DavidMS51/TFWordclock/8x8r8a.pdf

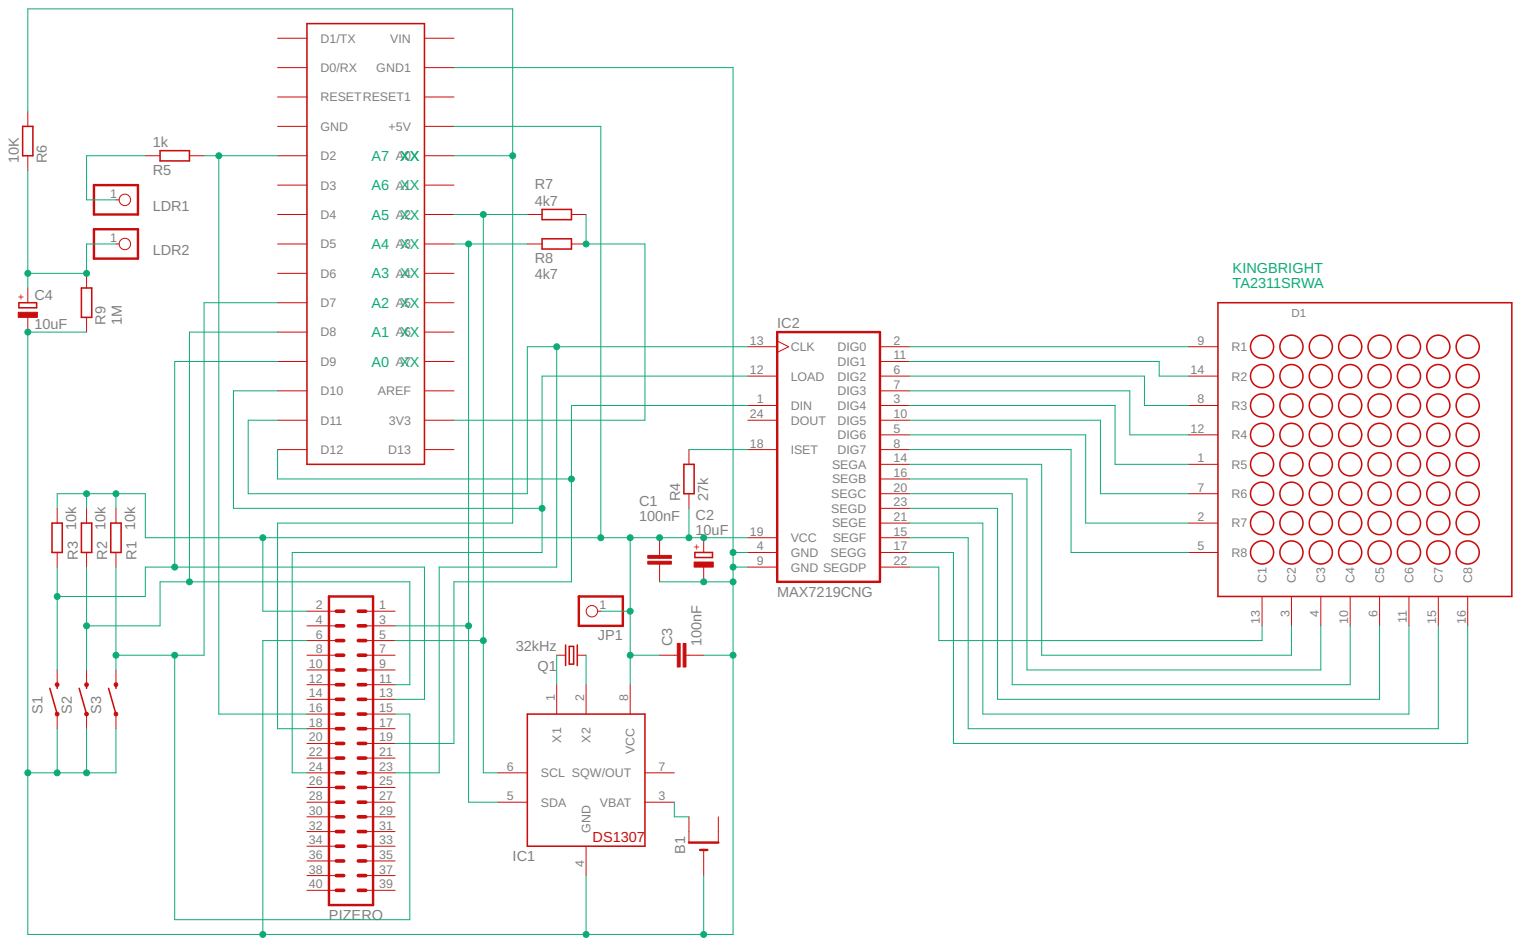
[picture p50: page 1]
