DavidMS51/TFWordclock/(commit log)

2016-05-18 Beta Arduino software added
2016-05-27 fixed spelling on a few strings
    [FT_WordClock_R1_English.ino]
2016-06-19 Update to Python code to include rotation feature
    Rotation option added to Python code
    manual updated to reflect this and some other minor corrections /
    improvements made
    [Wordclockr1.py, Wordclockr2.py, timewrd2ca.py, timewrd3ca.py]
2016-07-24 s/w update to add various 'blink' options
    option to
    - reduce / turn off activity led blinking
    - blink minutes display to indicate number of minutes after currently
    displayed time (see instruction manual) for details
    various typos to corrected
    enabling code for German version added - not active with this release
    [Wordclockr2.py, timewrd3ca.py]
2016-07-29 German Nano Beta
    Thanks to Klaus Kreiner for this. Not having ever studied German It
    would be good confirmation from any other German speaking TF owns that
    time syntax is correct
    [FT_WordClock_R1_German.ino, adjustBrightness.ino, demo_mode.ino, displayTime.ino, keypres.ino, st_display.ino, update_EEPROM.ino, update_RTC.ino]
2017-02-13 added depciated test s/w
    This version is no longer available on the source site. The trouble is
    the new version will not work with old drivers .....
2018-01-14 Prep for Rev 5
    Rev 3 and before moved to TFWordclock Legacy - not these will not work
    with current Raspian release
    [Wordclockr1.py, Wordclockr2.py, timewrd2ca.py, timewrd3ca.py]
2018-01-14 Inital Rev s/w release
    code extensivly changed to use current luma.led_matrix libuary.
    Currently only English support available. The change of libuary has
    requried a number of other changes - please check updated instructions
    [rev 8 ]
2018-02-18 Correct error in Dutch time version
    need to increment hour after quater past
    [timewrd5ca_du.py]
2021-12-01 Add files via upload
    TFWordclock circuit provided for information only
